cinzotechnologies/RelaxPump/hardware/pcb-v2-netlist.csv

Ref | Pin | Pin name | Net
U1 | L1 | 3V3 | +3V3
U1 | L2 | EN | EN
U1 | L3 | SENSOR_VP / G36 | NC
U1 | L4 | SENSOR_VN / G39 | ECHO_MAIN
U1 | L5 | G34 | ECHO_T4
U1 | L6 | G35 | ECHO_T5
U1 | L7 | G32 | GATE_V4
U1 | L8 | G33 | GATE_PUMP
U1 | L9 | G25 | GATE_V1
U1 | L10 | G26 | GATE_V2
U1 | L11 | G27 | GATE_V3
U1 | L12 | G14 | TRIG_T5_IO
U1 | L13 | G12 | NC (strapping)
U1 | L14 | GND | GND
U1 | L15 | G13 | TRIG_T4_IO
U1 | L16 | SD2 / G9 | NC (flash)
U1 | L17 | SD3 / G10 | NC (flash)
U1 | L18 | CMD / G11 | NC (flash)
U1 | L19 | 5V | +5V
U1 | R1 | GND | GND
U1 | R2 | G23 | TRIG_T3_IO
U1 | R3 | G22 | GATE_V5
U1 | R4 | TX / G1 | NC (USB serial)
U1 | R5 | RX / G3 | NC (USB serial)
U1 | R6 | G21 | TRIG_MAIN_IO
U1 | R7 | GND | GND
U1 | R8 | G19 | ECHO_T2
U1 | R9 | G18 | TRIG_T2_IO
U1 | R10 | G5 | SPARE_G5
U1 | R11 | G17 | ECHO_T1
U1 | R12 | G16 | TRIG_T1_IO
U1 | R13 | G4 | ECHO_T3
U1 | R14 | G0 | SW_SETUP
U1 | R15 | G2 | LED_STATUS
U1 | R16 | G15 | NC (strapping)
U1 | R17 | SD1 / G8 | NC (flash)
U1 | R18 | SD0 / G7 | NC (flash)
U1 | R19 | CLK / G6 | NC (flash)
J1 | 1 | + | VIN_RAW
J1 | 2 | − | GND
F1 | 1 | IN | VIN_RAW
F1 | 2 | OUT | VIN_FUSED
D1 | A | Anode | VIN_FUSED
D1 | K | Cathode | +12V
D2 | K | Cathode | +12V
D2 | A | Anode | GND
C1 | + | + | +12V
C1 | − | − | GND
C2 | 1 | 1 | +12V
C2 | 2 | 2 | GND
U2 | 1 | IN+ | +12V
U2 | 2 | IN− | GND
U2 | 3 | OUT+ | +5V
U2 | 4 | OUT− | GND
C3 | + | + | +5V
C3 | − | − | GND
C4 | 1 | 1 | +5V
C4 | 2 | 2 | GND
LED8 | A | Anode | PWR_LED_A
LED8 | K | Cathode | GND
R38 | 1 | 1 | +5V
R38 | 2 | 2 | PWR_LED_A
J2 | 1 | +12V | +12V
J2 | 2 | SW− | V1_OUT
Q1 | G | Gate | GATE_V1_G
Q1 | S | Source | GND
Q1 | D | Drain | V1_OUT
R7 | 1 | 1 | GATE_V1
R7 | 2 | 2 | GATE_V1_G
R13 | 1 | 1 | GATE_V1_G
R13 | 2 | 2 | GND
D3 | K | Cathode | +12V
D3 | A | Anode | V1_OUT
R1 | 1 | 1 | +12V
R1 | 2 | 2 | V1_LED_A
LED1 | A | Anode | V1_LED_A
LED1 | K | Cathode | V1_OUT
J3 | 1 | +12V | +12V
J3 | 2 | SW− | V2_OUT
Q2 | G | Gate | GATE_V2_G
Q2 | S | Source | GND
Q2 | D | Drain | V2_OUT
R8 | 1 | 1 | GATE_V2
R8 | 2 | 2 | GATE_V2_G
R14 | 1 | 1 | GATE_V2_G
R14 | 2 | 2 | GND
D4 | K | Cathode | +12V
D4 | A | Anode | V2_OUT
R2 | 1 | 1 | +12V
R2 | 2 | 2 | V2_LED_A
LED2 | A | Anode | V2_LED_A
LED2 | K | Cathode | V2_OUT
J4 | 1 | +12V | +12V
J4 | 2 | SW− | V3_OUT
Q3 | G | Gate | GATE_V3_G
Q3 | S | Source | GND
Q3 | D | Drain | V3_OUT
R9 | 1 | 1 | GATE_V3
R9 | 2 | 2 | GATE_V3_G
R15 | 1 | 1 | GATE_V3_G
R15 | 2 | 2 | GND
D5 | K | Cathode | +12V
D5 | A | Anode | V3_OUT
R3 | 1 | 1 | +12V
R3 | 2 | 2 | V3_LED_A
LED3 | A | Anode | V3_LED_A
LED3 | K | Cathode | V3_OUT
J5 | 1 | +12V | +12V
J5 | 2 | SW− | V4_OUT
Q4 | G | Gate | GATE_V4_G
Q4 | S | Source | GND
Q4 | D | Drain | V4_OUT
R10 | 1 | 1 | GATE_V4
R10 | 2 | 2 | GATE_V4_G
R16 | 1 | 1 | GATE_V4_G
R16 | 2 | 2 | GND
D6 | K | Cathode | +12V
D6 | A | Anode | V4_OUT
R4 | 1 | 1 | +12V
R4 | 2 | 2 | V4_LED_A
LED4 | A | Anode | V4_LED_A
LED4 | K | Cathode | V4_OUT
J6 | 1 | +12V | +12V
J6 | 2 | SW− | V5_OUT
Q5 | G | Gate | GATE_V5_G
Q5 | S | Source | GND
Q5 | D | Drain | V5_OUT
R11 | 1 | 1 | GATE_V5
R11 | 2 | 2 | GATE_V5_G
R17 | 1 | 1 | GATE_V5_G
R17 | 2 | 2 | GND
D7 | K | Cathode | +12V
D7 | A | Anode | V5_OUT
R5 | 1 | 1 | +12V
R5 | 2 | 2 | V5_LED_A
LED5 | A | Anode | V5_LED_A
LED5 | K | Cathode | V5_OUT
J7 | 1 | +12V | +12V
J7 | 2 | SW− | PUMP_OUT
Q6 | G | Gate | GATE_PUMP_G
Q6 | S | Source | GND
Q6 | D | Drain | PUMP_OUT
R12 | 1 | 1 | GATE_PUMP
R12 | 2 | 2 | GATE_PUMP_G
R18 | 1 | 1 | GATE_PUMP_G
R18 | 2 | 2 | GND
D8 | K | Cathode | +12V
D8 | A | Anode | PUMP_OUT
R6 | 1 | 1 | +12V
R6 | 2 | 2 | PUMP_LED_A
LED6 | A | Anode | PUMP_LED_A
LED6 | K | Cathode | PUMP_OUT
J8 | 1 | orange-white | NC
J8 | 2 | orange | NC
J8 | 3 | green-white | GND
J8 | 4 | blue | TRIG_T1
J8 | 5 | blue-white | GND
J8 | 6 | green | ECHO_T1_5V
J8 | 7 | brown-white | GND
J8 | 8 | brown | +5V
R31 | 1 | 1 | TRIG_T1_IO
R31 | 2 | 2 | TRIG_T1
R19 | 1 | 1 | ECHO_T1_5V
R19 | 2 | 2 | ECHO_T1
R25 | 1 | 1 | ECHO_T1
R25 | 2 | 2 | GND
D9 | 1 | IO1 | TRIG_T1
D9 | 2 | IO2 | ECHO_T1_5V
D9 | 3 | GND | GND
J9 | 1 | orange-white | NC
J9 | 2 | orange | NC
J9 | 3 | green-white | GND
J9 | 4 | blue | TRIG_T2
J9 | 5 | blue-white | GND
J9 | 6 | green | ECHO_T2_5V
J9 | 7 | brown-white | GND
J9 | 8 | brown | +5V
R32 | 1 | 1 | TRIG_T2_IO
R32 | 2 | 2 | TRIG_T2
R20 | 1 | 1 | ECHO_T2_5V
R20 | 2 | 2 | ECHO_T2
R26 | 1 | 1 | ECHO_T2
R26 | 2 | 2 | GND
D10 | 1 | IO1 | TRIG_T2
D10 | 2 | IO2 | ECHO_T2_5V
D10 | 3 | GND | GND
J10 | 1 | orange-white | NC
J10 | 2 | orange | NC
J10 | 3 | green-white | GND
J10 | 4 | blue | TRIG_T3
J10 | 5 | blue-white | GND
J10 | 6 | green | ECHO_T3_5V
J10 | 7 | brown-white | GND
J10 | 8 | brown | +5V
R33 | 1 | 1 | TRIG_T3_IO
R33 | 2 | 2 | TRIG_T3
R21 | 1 | 1 | ECHO_T3_5V
R21 | 2 | 2 | ECHO_T3
R27 | 1 | 1 | ECHO_T3
R27 | 2 | 2 | GND
D11 | 1 | IO1 | TRIG_T3
D11 | 2 | IO2 | ECHO_T3_5V
D11 | 3 | GND | GND
J11 | 1 | orange-white | NC
J11 | 2 | orange | NC
J11 | 3 | green-white | GND
J11 | 4 | blue | TRIG_T4
J11 | 5 | blue-white | GND
J11 | 6 | green | ECHO_T4_5V
J11 | 7 | brown-white | GND
J11 | 8 | brown | +5V
R34 | 1 | 1 | TRIG_T4_IO
R34 | 2 | 2 | TRIG_T4
R22 | 1 | 1 | ECHO_T4_5V
R22 | 2 | 2 | ECHO_T4
R28 | 1 | 1 | ECHO_T4
R28 | 2 | 2 | GND
D12 | 1 | IO1 | TRIG_T4
D12 | 2 | IO2 | ECHO_T4_5V
D12 | 3 | GND | GND
J12 | 1 | orange-white | NC
J12 | 2 | orange | NC
J12 | 3 | green-white | GND
J12 | 4 | blue | TRIG_T5
J12 | 5 | blue-white | GND
J12 | 6 | green | ECHO_T5_5V
J12 | 7 | brown-white | GND
J12 | 8 | brown | +5V
R35 | 1 | 1 | TRIG_T5_IO
R35 | 2 | 2 | TRIG_T5
R23 | 1 | 1 | ECHO_T5_5V
R23 | 2 | 2 | ECHO_T5
R29 | 1 | 1 | ECHO_T5
R29 | 2 | 2 | GND
D13 | 1 | IO1 | TRIG_T5
D13 | 2 | IO2 | ECHO_T5_5V
D13 | 3 | GND | GND
J13 | 1 | orange-white | NC
J13 | 2 | orange | NC
J13 | 3 | green-white | GND
J13 | 4 | blue | TRIG_MAIN
J13 | 5 | blue-white | GND
J13 | 6 | green | ECHO_MAIN_5V
J13 | 7 | brown-white | GND
J13 | 8 | brown | +5V
R36 | 1 | 1 | TRIG_MAIN_IO
R36 | 2 | 2 | TRIG_MAIN
R24 | 1 | 1 | ECHO_MAIN_5V
R24 | 2 | 2 | ECHO_MAIN
R30 | 1 | 1 | ECHO_MAIN
R30 | 2 | 2 | GND
D14 | 1 | IO1 | TRIG_MAIN
D14 | 2 | IO2 | ECHO_MAIN_5V
D14 | 3 | GND | GND
LED7 | A | Anode | LED_STATUS_A
LED7 | K | Cathode | GND
R37 | 1 | 1 | LED_STATUS
R37 | 2 | 2 | LED_STATUS_A
SW1 | 1 | 1 | SW_SETUP
SW1 | 2 | 2 | GND
SW2 | 1 | 1 | EN
SW2 | 2 | 2 | GND
J14 | 1 | 3V3 | +3V3
J14 | 2 | G5 | SPARE_G5
J14 | 3 | GND | GND
