cinzotechnologies/RelaxPump/HOW-TO-V2-MIZO.md

# RelaxPump v2 (tank 1–5) – Claude Code-a siam dan

Plan kim chu `docs/flexible-system.md` ah a awm a, app screen design thar chu `reference/design-v2/` ah a awm.

- Semi tank 1–5, tank tinah sensor + valve (tank 1 chauh chuan sensor chauh).
- Relay 6: valve 5 + pump 1. Main tank sensor duh thlan theih. PHE a awm lo.

1. Terminal hawng la:

   ```
   cd D:\RelaxPump-kit
   claude
   ```

2. Folder access a dil chuan **Allow** ti rawh.
3. `FLEX_START_PROMPT.txt` chhunga thu zawng zawng copy la, Claude Code-ah paste rawh.
4. Milestone plan a lantir hunah en la, "OK, tan rawh" ti rawh.
5. Milestone tin zawhah app hi design-v2 nen khaikhin rawh. A danglam chuan file hming sawiin hrilh rawh.
6. Board flash, wiring emaw Firebase emaw a ngaih hunah step a rawn hrilh ang che.

**Hriat tur:** website (`web/`) leh hei hi Claude Code session hrang hrangah ti rawh.
