cinzotechnologies/RelaxPump/HOW-TO-MIZO.md

# RelaxPump – Claude Code-a tan dan

1. He folder (RelaxPump-kit) hi i computer-ah dah la, a hming "RelaxPump" ah thlak rawh.
2. Terminal hawng la, chu folder-ah lut rawh:  cd RelaxPump
3. Claude Code tan rawh:  claude
4. START_PROMPT.txt chhunga thu zawng zawng kha copy la, Claude Code-ah paste rawh.
5. A plan a rawn lantir hunah en la, "OK, tan rawh" ti rawh.
6. Firebase console, phone emaw ESP32 lamah i thiltih tur a awm chuan a rawn hrilh ang che.

CLAUDE.md hi Claude Code-in a chhiar nghal ang. Chu chuan project dan zawng zawng a sawi a ni.
google-services.json leh secrets.h hi repo-ah push suh (repo hi public a ni).
