cinzotechnologies/RelaxPump/hardware/kicad/RelaxPump_v2.kicad_sch

## KiCad design hardware/kicad/RelaxPump_v2.kicad_sch (2026-11-10)

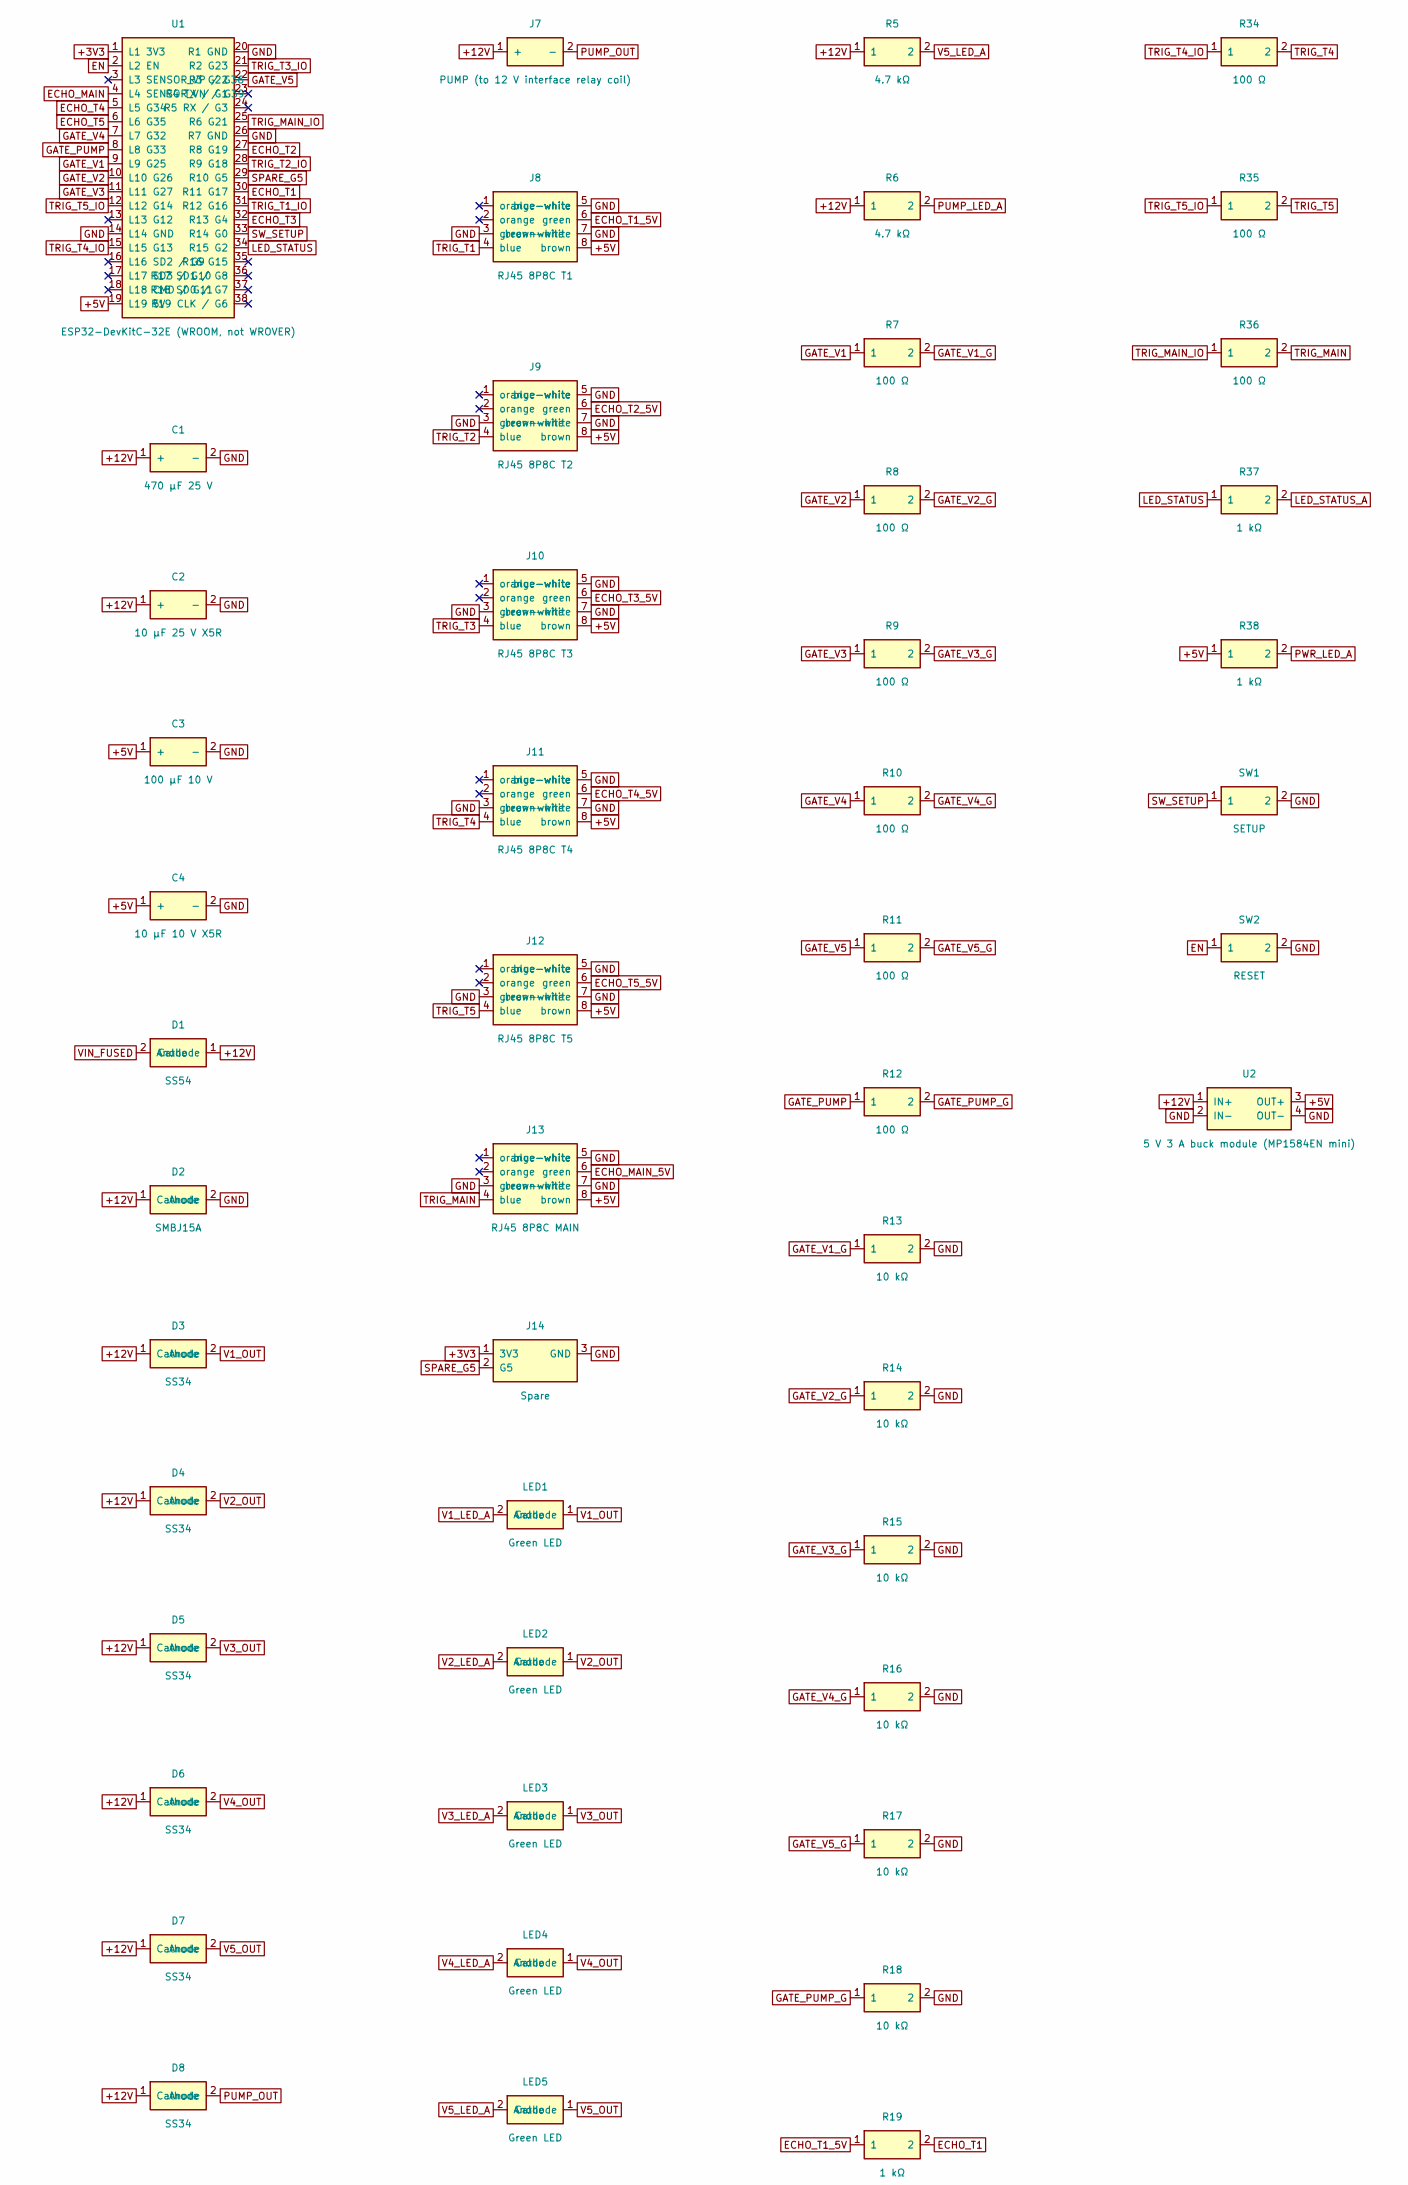
[picture p14: schematic RelaxPump_v2.kicad_sch, part in row 1, column 1]

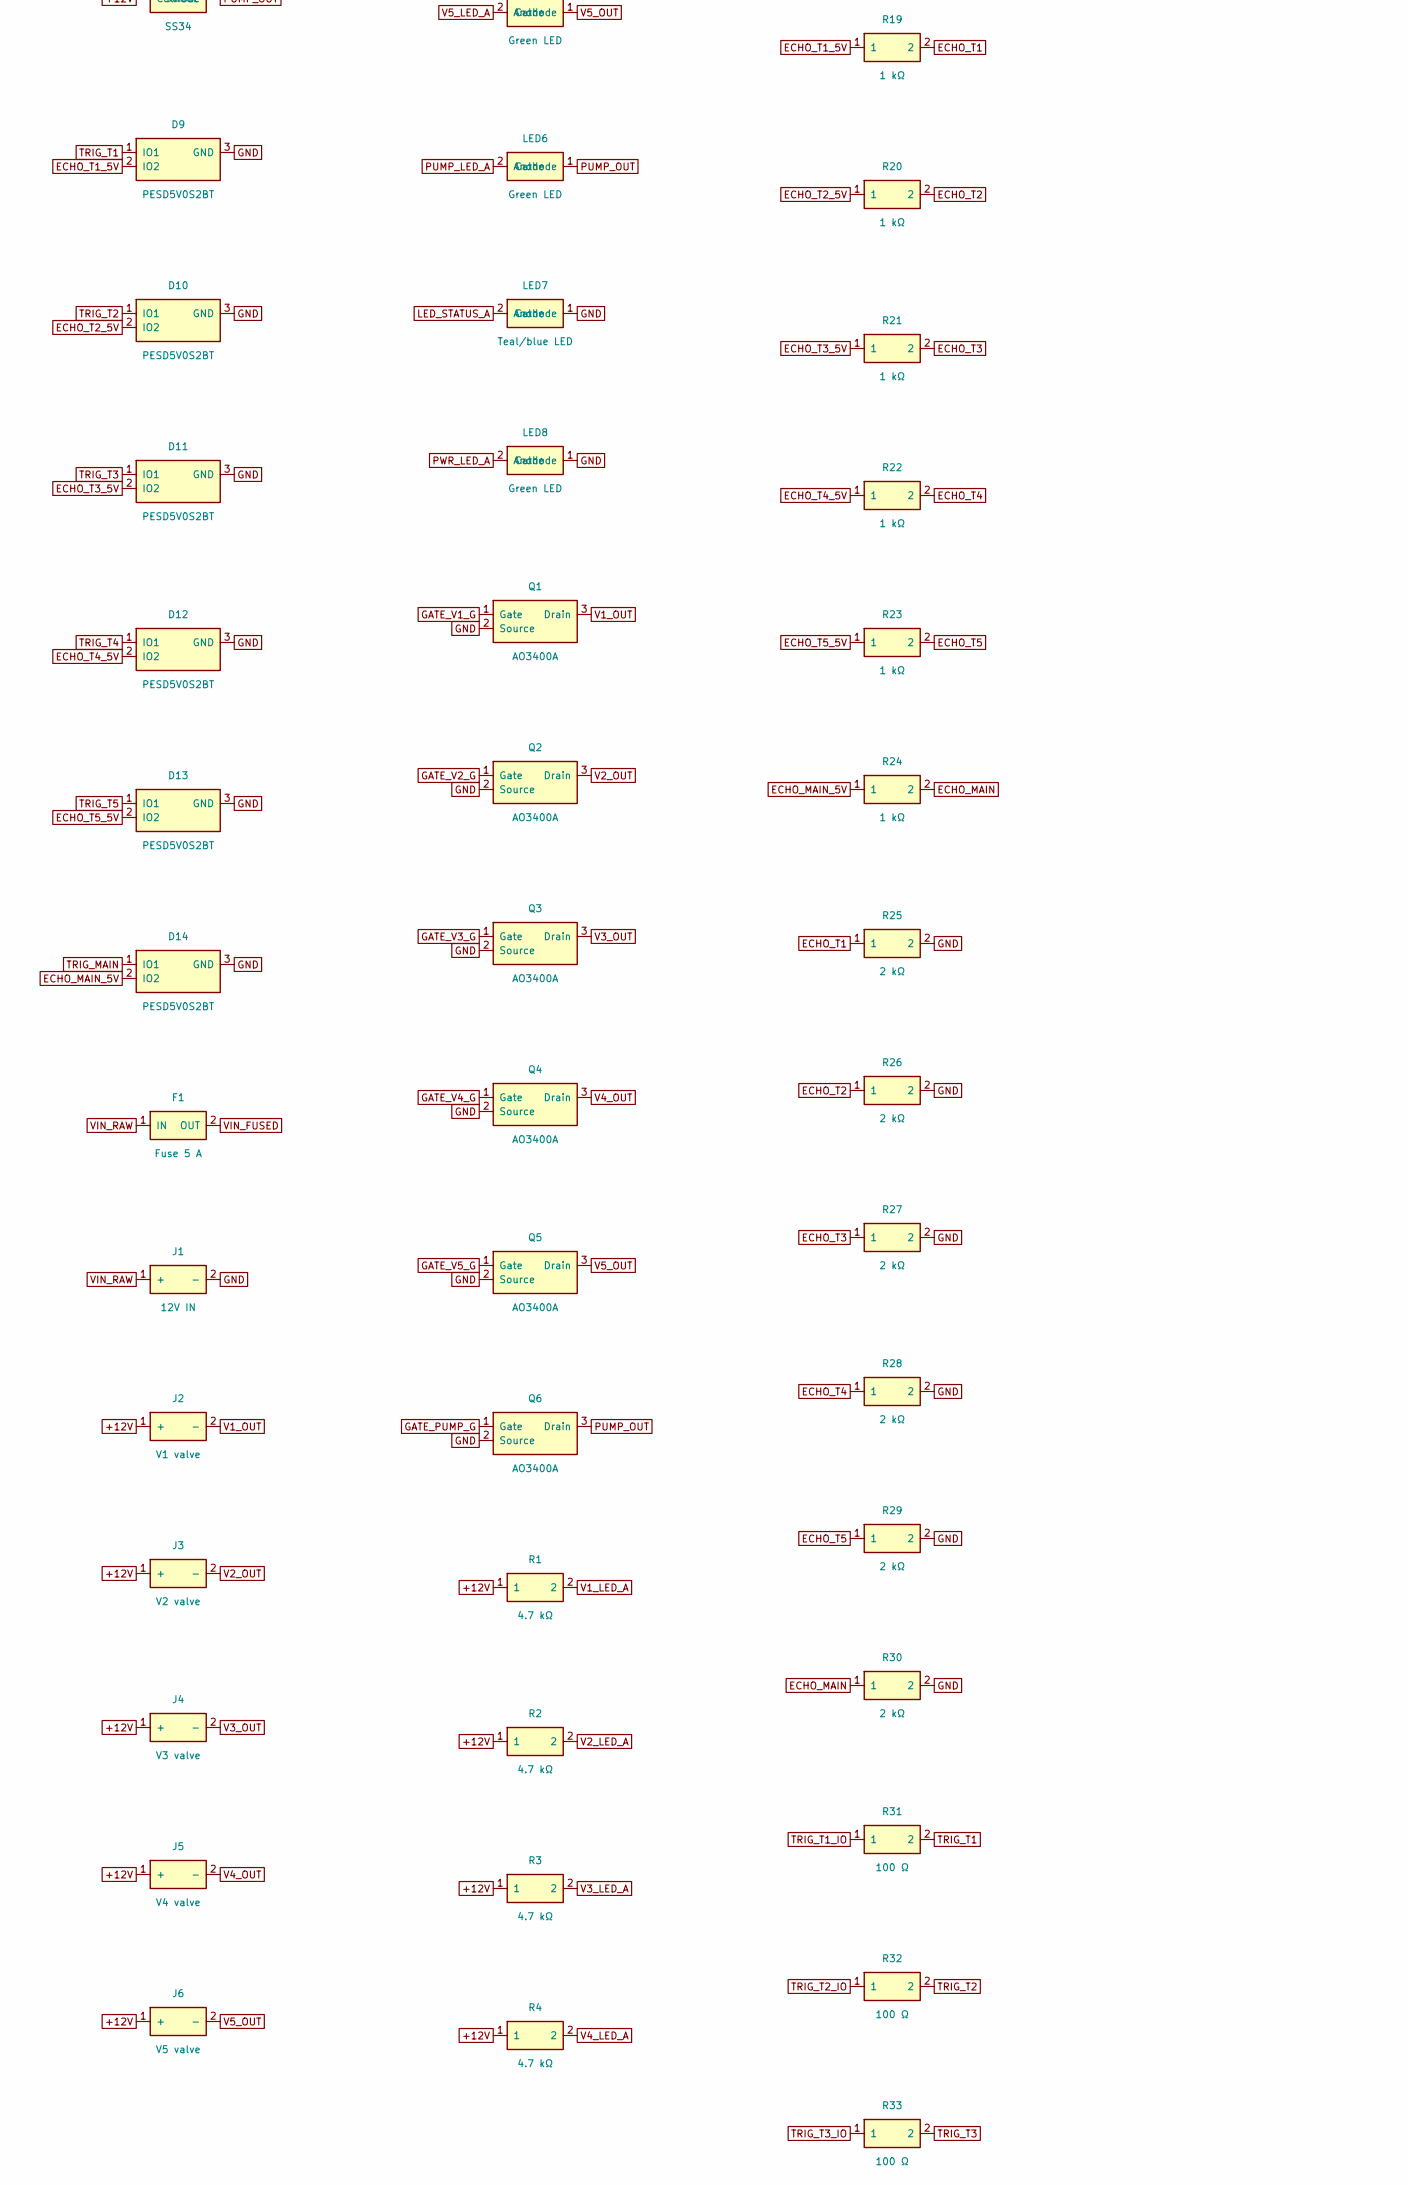
[picture p15: schematic RelaxPump_v2.kicad_sch, part in row 2, column 1]

Parts:
C1: 470 µF 25 V; CP_Radial_D10.0mm_P5.00mm
C2: 10 µF 25 V X5R; C_1206_3216Metric
C3: 100 µF 10 V; CP_Radial_D6.3mm_P2.50mm
C4: 10 µF 10 V X5R; C_0805_2012Metric
D1: SS54; D_SMA
D2: SMBJ15A; D_SMB
D3, D4, D5, D6, D7, D8: SS34; D_SMA
D9, D10, D11, D12, D13, D14: PESD5V0S2BT; SOT-23
F1: Fuse 5 A; Fuseholder_Blade_Mini_Keystone_3568
J1: 12V IN; TerminalBlock_Phoenix_MKDS-1,5-2-5.08_1x02_P5.08mm_Horizont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
J2: V1 valve; TerminalBlock_Phoenix_MKDS-1,5-2-5.08_1x02_P5.08mm_Horizont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
J3: V2 valve; TerminalBlock_Phoenix_MKDS-1,5-2-5.08_1x02_P5.08mm_Horizont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
J4: V3 valve; TerminalBlock_Phoenix_MKDS-1,5-2-5.08_1x02_P5.08mm_Horizont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
J5: V4 valve; TerminalBlock_Phoenix_MKDS-1,5-2-5.08_1x02_P5.08mm_Horizont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
J6: V5 valve; TerminalBlock_Phoenix_MKDS-1,5-2-5.08_1x02_P5.08mm_Horizont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
J7: PUMP (to 12 V interface relay coil); TerminalBlock_Phoenix_MKDS-1,5-2-5.08_1x02_P5.08mm_Horizont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
J8: RJ45 8P8C T1; RJ45_Amphenol_54602-x08_Horizontal
J9: RJ45 8P8C T2; RJ45_Amphenol_54602-x08_Horizontal
J10: RJ45 8P8C T3; RJ45_Amphenol_54602-x08_Horizontal
J11: RJ45 8P8C T4; RJ45_Amphenol_54602-x08_Horizontal
J12: RJ45 8P8C T5; RJ45_Amphenol_54602-x08_Horizontal
J13: RJ45 8P8C MAIN; RJ45_Amphenol_54602-x08_Horizontal
J14: Spare; PinHeader_1x03_P2.54mm_Vertical
LED1, LED2, LED3, LED4, LED5, LED6, LED8: Green LED; LED_0805_2012Metric
LED7: Teal/blue LED; LED_0805_2012Metric
Q1, Q2, Q3, Q4, Q5, Q6: AO3400A; SOT-23
R1, R2, R3, R4, R5, R6: 4.7 kΩ; R_0603_1608Metric
R7, R8, R9, R10, R11, R12, R31, R32, R33, R34, R35, R36: 100 Ω; R_0603_1608Metric
R13, R14, R15, R16, R17, R18: 10 kΩ; R_0603_1608Metric
R19, R20, R21, R22, R23, R24, R37, R38: 1 kΩ; R_0603_1608Metric
R25, R26, R27, R28, R29, R30: 2 kΩ; R_0603_1608Metric
SW1: SETUP; SW_PUSH_6mm
SW2: RESET; SW_PUSH_6mm
U1: ESP32-DevKitC-32E (WROOM, not WROVER); ESP32-DevKitC-38pin_2x19_P2.54mm_Row25.4mm
U2: 5 V 3 A buck module (MP1584EN mini); MP1584_Module_4pin

Connections:
+3V3: J14.1 (3V3), U1.1 (L1 3V3)
+5V: C3.1 (+), C4.1 (+), J8.8 (brown), J9.8 (brown), J10.8 (brown), J11.8 (brown), J12.8 (brown), J13.8 (brown), R38.1, U1.19 (L19 5V), U2.3 (OUT+)
+12V: C1.1 (+), C2.1 (+), D1.1 (Cathode), D2.1 (Cathode), D3.1 (Cathode), D4.1 (Cathode), D5.1 (Cathode), D6.1 (Cathode), D7.1 (Cathode), D8.1 (Cathode), J2.1 (+), J3.1 (+), J4.1 (+), J5.1 (+), J6.1 (+), J7.1 (+), R1.1, R2.1, R3.1, R4.1, R5.1, R6.1, U2.1 (IN+)
ECHO_MAIN: R24.2, R30.1, U1.4 (L4 SENSOR_VN / G39)
ECHO_MAIN_5V: D14.2 (IO2), J13.6 (green), R24.1
ECHO_T1: R19.2, R25.1, U1.30 (R11 G17)
ECHO_T1_5V: D9.2 (IO2), J8.6 (green), R19.1
ECHO_T2: R20.2, R26.1, U1.27 (R8 G19)
ECHO_T2_5V: D10.2 (IO2), J9.6 (green), R20.1
ECHO_T3: R21.2, R27.1, U1.32 (R13 G4)
ECHO_T3_5V: D11.2 (IO2), J10.6 (green), R21.1
ECHO_T4: R22.2, R28.1, U1.5 (L5 G34)
ECHO_T4_5V: D12.2 (IO2), J11.6 (green), R22.1
ECHO_T5: R23.2, R29.1, U1.6 (L6 G35)
ECHO_T5_5V: D13.2 (IO2), J12.6 (green), R23.1
EN: SW2.1, U1.2 (L2 EN)
GATE_PUMP: R12.1, U1.8 (L8 G33)
GATE_PUMP_G: Q6.1 (Gate), R12.2, R18.1
GATE_V1: R7.1, U1.9 (L9 G25)
GATE_V1_G: Q1.1 (Gate), R7.2, R13.1
GATE_V2: R8.1, U1.10 (L10 G26)
GATE_V2_G: Q2.1 (Gate), R8.2, R14.1
GATE_V3: R9.1, U1.11 (L11 G27)
GATE_V3_G: Q3.1 (Gate), R9.2, R15.1
GATE_V4: R10.1, U1.7 (L7 G32)
GATE_V4_G: Q4.1 (Gate), R10.2, R16.1
GATE_V5: R11.1, U1.22 (R3 G22)
GATE_V5_G: Q5.1 (Gate), R11.2, R17.1
GND: C1.2 (−), C2.2 (−), C3.2 (−), C4.2 (−), D2.2 (Anode), D9.3 (GND), D10.3 (GND), D11.3 (GND), D12.3 (GND), D13.3 (GND), D14.3 (GND), J1.2 (−), J8.3 (green-white), J8.5 (blue-white), J8.7 (brown-white), J9.3 (green-white), J9.5 (blue-white), J9.7 (brown-white), J10.3 (green-white), J10.5 (blue-white), J10.7 (brown-white), J11.3 (green-white), J11.5 (blue-white), J11.7 (brown-white), J12.3 (green-white), J12.5 (blue-white), J12.7 (brown-white), J13.3 (green-white), J13.5 (blue-white), J13.7 (brown-white), J14.3 (GND), LED7.1 (Cathode), LED8.1 (Cathode), Q1.2 (Source), Q2.2 (Source), Q3.2 (Source), Q4.2 (Source), Q5.2 (Source), Q6.2 (Source), R13.2, R14.2, R15.2, R16.2, R17.2, R18.2, R25.2, R26.2, R27.2, R28.2, R29.2, R30.2, SW1.2, SW2.2, U1.14 (L14 GND), U1.20 (R1 GND), U1.26 (R7 GND), U2.2 (IN−), U2.4 (OUT−)
LED_STATUS: R37.1, U1.34 (R15 G2)
LED_STATUS_A: LED7.2 (Anode), R37.2
PUMP_LED_A: LED6.2 (Anode), R6.2
PUMP_OUT: D8.2 (Anode), J7.2 (−), LED6.1 (Cathode), Q6.3 (Drain)
PWR_LED_A: LED8.2 (Anode), R38.2
SPARE_G5: J14.2 (G5), U1.29 (R10 G5)
SW_SETUP: SW1.1, U1.33 (R14 G0)
TRIG_MAIN: D14.1 (IO1), J13.4 (blue), R36.2
TRIG_MAIN_IO: R36.1, U1.25 (R6 G21)
TRIG_T1: D9.1 (IO1), J8.4 (blue), R31.2
TRIG_T1_IO: R31.1, U1.31 (R12 G16)
TRIG_T2: D10.1 (IO1), J9.4 (blue), R32.2
TRIG_T2_IO: R32.1, U1.28 (R9 G18)
TRIG_T3: D11.1 (IO1), J10.4 (blue), R33.2
TRIG_T3_IO: R33.1, U1.21 (R2 G23)
TRIG_T4: D12.1 (IO1), J11.4 (blue), R34.2
TRIG_T4_IO: R34.1, U1.15 (L15 G13)
TRIG_T5: D13.1 (IO1), J12.4 (blue), R35.2
TRIG_T5_IO: R35.1, U1.12 (L12 G14)
V1_LED_A: LED1.2 (Anode), R1.2
V1_OUT: D3.2 (Anode), J2.2 (−), LED1.1 (Cathode), Q1.3 (Drain)
V2_LED_A: LED2.2 (Anode), R2.2
V2_OUT: D4.2 (Anode), J3.2 (−), LED2.1 (Cathode), Q2.3 (Drain)
V3_LED_A: LED3.2 (Anode), R3.2
V3_OUT: D5.2 (Anode), J4.2 (−), LED3.1 (Cathode), Q3.3 (Drain)
V4_LED_A: LED4.2 (Anode), R4.2
V4_OUT: D6.2 (Anode), J5.2 (−), LED4.1 (Cathode), Q4.3 (Drain)
V5_LED_A: LED5.2 (Anode), R5.2
V5_OUT: D7.2 (Anode), J6.2 (−), LED5.1 (Cathode), Q5.3 (Drain)
VIN_FUSED: D1.2 (Anode), F1.2 (OUT)
VIN_RAW: F1.1 (IN), J1.1 (+)
