cinzotechnologies/RelaxPump/(commit log)

2026-11-07 M1: repo scaffold (Expo SDK 58 app, PlatformIO, Firebase, docs)
    - app/: Expo Router + TypeScript strict, dev-client, React Native Firebase,
    ESP-IDF BLE provisioning, Reanimated, SVG, bottom sheet, zustand, RHF+zod
    - app.config.ts reads google-services.json from EAS file env when building
    - eas.json with development / preview (APK) / production profiles
    - ESLint (expo) + Prettier + Jest (jest-expo)
    - firmware/ PlatformIO skeleton and tools/ValveTest
    - firebase/ config with locked rules placeholder
    - docs/ hardware plan PDF
2026-11-07 M2+M3: theme, components and all screens on a mock backend
    - Theme tokens, scaled sizes (390 design width), Inter/Outfit type
    - Components: level-ring logo, animated welcome tank, two-layer waves,
    toggle, range slider, segmented control, progress ring, sheets, nav, toast
    - Screens: Welcome, Auth, Home, Tanks, Usage, Account
    - Sheets: Your tanks, Change password, Notifications, Forgot password,
    Bluetooth setup (mock provisioning)
    - Backend interface with an in-memory simulator (Expo Go friendly)
    - Pump safety helpers + unit tests
2026-11-07 M4+M5 (app): Firebase backend, QR + BLE provisioning, device claim
    - Firebase Auth with phone → synthetic email, profile in users/{uid}
    - Live RTDB device info/state/config/events/usage, commands and config writes
    - Claim: SHA-256(deviceId:code) checked by rules, one atomic multi-path write
    - Bluetooth setup: scan box QR (id, PoP, claim code), ESP-IDF BLE
    provisioning (security 1), then claim
    - Expo Go automatically uses the simulator and mock provisioning
    - Local notifications for controller events while the app runs
2026-11-07 M7+M8: database rules with emulator tests, admin scripts, docs
    - database.rules.json: owner-only device access, verified device accounts,
    hash-checked claiming, validated config/cmd/events/usage
    - 18 emulator tests (@firebase/rules-unit-testing), all passing
    - scripts: new-device (device login, claim hash, secrets.h, box QR),
    reset-password (support), fake-device (end-to-end test without ESP32)
    - Cloud Functions stub for Blaze (not deployed)
    - docs: SETUP, data model, Blaze upgrade
2026-11-07 M6: ESP32 firmware with BLE provisioning and Firebase
    - WiFiProv BLE (security 1 + PoP), service RelaxPump-XXXX, BLE memory freed after setup
    - BOOT held 5 s forgets Wi-Fi; status LED patterns; OTA; 15 s task watchdog
    - Safety state machine from the legacy sketch: valve lead 2 s, stop delay 3 s,
    never pump with all valves closed, one tank at a time, max run time,
    dry-run check, 60 s cooldown, stop on sensor error, offline guard
    - Auto fills the lowest tank below Start up to Stop, then the next
    - FirebaseClient: device login, config/cmd streams, state every 3 s and on
    change, events, usage with server-side increments; settings kept in flash
    - Serial bench commands kept; docs/wiring.md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
    [cloud.cpp, cloud.h, config.h, main.cpp]
2026-11-07 Add link-device support script; setup doc for fake device testing
2026-11-08 Store readiness: delete account, offline-safe remote control, quieter nav
    - Account: "Delete account" sheet (Play Store / App Store requirement). Re-auths,
    releases the user's controllers, removes users/{uid}, deletes the auth user.
    - Remote control over Wi-Fi: online state is re-checked every 5 s against server
    time (.info/serverTimeOffset), so a controller that loses power shows Offline.
    Pump / valve / auto commands are refused while offline instead of queueing.
    - Firmware: ignore commands older than 60 s (queued while offline).
    - Bottom nav: icon-only tabs; active tab is a small see-through teal circle with a
    glowing icon instead of a wide solid pill.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
2026-11-08 Notify for everything Auto does; push-ready (FCM tokens)
    - App: local notification now also for pump start/stop done by Auto (not for the
    user's own taps), plus full/low/fault events as before. All events stay in the
    bell list.
    - App saves this phone's FCM token at users/{uid}/fcm/{token} on sign-in, keeps it
    fresh, removes it on sign-out (delete account wipes it with the profile).
    - Rules: users/{uid}/fcm/{token} = true, owner only; emulator test (20/20).
    - Cloud Function onDeviceEvent (still undeployed, needs Blaze): uses tank names,
    pushes auto pump start/stop too, prunes dead tokens.
2026-11-08 W2: colour tokens, shared UI and the site shell (top bar + footer)
    - styles/tokens.ts is the single colour source (brief theme + design shades +
    artwork); the root layout emits them as CSS variables (--ink, --ink-rgb …).
    - styles/site.css: type, white outlined buttons / icon buttons / chips with
    press = scale only, entry + scroll-reveal motion, reduced-motion, and the
    1100 / 820 container breakpoints from the design.
    - Logo, LogoMark, Wordmark, stroke icons; sticky white TopBar with the phone
    burger dropdown; dark Footer with contact info (seed values for now).
    - Playwright screenshot run at 1440 and 390.
2026-11-08 W3: home page — all sections from Main.dc.html at 1440 and 390
    - Hero (16:9, slow zoom photo, white fades, glass outlined buttons, chips).
    - How it works: 4 slides, 6 s auto-advance with progress tabs, clip-path panel
    wipe, phone slide/rotate, outlined big number.
    - App screens: looped coverflow of the 6 AppScreen mockups, chips + arrows.
    - Install guide: 16:9 player, chapters, "Video coming soon" until a video or
    YouTube link exists.
    - Manual: hardcover book with leaves turning around the spine; phone = single
    pages peeling left.
    - Download card with SOON badges, store teaser with Notify me, dark footer.
    - AppScreen component (welcome/home/tanks/usage/ble/account) in the app's dark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
2026-11-08 W4: store page with cart drawer and checkout (ordering closed)
    - /store from Shop.dc.html: crumb, title, "orders open soon" note, category
    chips, product grid with add-to-cart steppers, "Not sure what you need?"
    card, why tiles, store top bar (Store current, cart button with count) and
    the shorter store footer.
    - Cart in localStorage (sanitised on load, max 99 per line), slide-in drawer,
    empty state, summary, checkout form (name, phone, address, town, PIN, COD /
    UPI). "Place order" stays disabled while ordering is closed.
    - Products moved to lib/content/products.ts (seed for D1): 5 items, category,
    nullable price (₹ when set), featured flag for the home teaser.
    - Fixes: closed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
2026-11-09 W7: website editor (draft → publish), media library (R2), preview
    - /admin/website: 8 sections per Admin.dc.html; text, textarea, link, toggle,
    image / video (upload or YouTube) / PDF fields; edits autosave as drafts,
    Publish copies drafts live in one D1 batch (+ store products and ordering
    switch), Discard drops them; "Unpublished changes" + per-section dots
    - Preview: admin-only draft mode shows unpublished changes on / and /store
    - /admin/media: upload (JPG/PNG/WebP/AVIF/GIF, MP4/WebM, PDF; no SVG) with
    progress, where each file is used, delete unused files
    - Server checks every field (https links only, uploads must be our own
    /media files, length limits); deep shape check of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
2026-11-09 W8: forgot-password requests (API, admin, Firebase update, WhatsApp)
    - POST /api/reset-requests (public, for the app): name + 10-digit phone,
    max 3 per phone and 10 per IP a day, one waiting row per phone; the
    answer never says whether the phone has an account
    - /admin/requests: Waiting / Done tabs, list, 3 steps per the design —
    set password (type or Generate: 8 chars, no look-alikes) → Open WhatsApp
    (wa.me with the design's message) → Mark as done (who + when)
    - Firebase: Identity Toolkit REST (accounts:lookup → accounts:update with
    validSince to sign out old sessions) with a service-account token signed
    in the Worker by jose — works on Spark; password never stored or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
2026-11-09 Release prep: push + cleanup on Cloudflare cron, app help/privacy, checklist
    - web/jobs (relaxpump-jobs Worker): every minute pushes new controller
    events to the owner's phones via FCM HTTP v1 (same texts as before, own
    taps skipped, dead tokens removed, per-device cursors in D1, request
    budget for the free plan); daily drops events > 30 days, usage > 1 year,
    handled password requests > 6 months. Replaces Cloud Functions, so the
    app needs no Blaze plan.
    - identity.accessToken takes a scope.
    - App: Account › Help & support (WhatsApp +91 98632 62589) and Privacy
    policy rows; real support number.
    - docs/release.md: secrets to set by hand, build, Play Console (privacy
    URL, data s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
2026-11-09 web: scripts/put-secrets.mjs — upload the three Firebase secrets in one go
2026-11-09 App: voice/shortcut pump control, stay signed in in demo mode
    - relaxpump://do/{pump-on,pump-off,auto-on,auto-off} run without a tap once
    signed in and the controller is online (2-minute expiry). Voice "pump on"
    opens the emptiest tank's valve first when none is open, then starts the
    pump after the controller applied it.
    - Android: app shortcuts + Google Assistant App Actions (custom intents
    with query patterns) via plugins/withVoiceShortcuts.js.
    - Siri: Shortcuts "Open URL" recipe documented (iOS app later).
    - Demo (Expo Go): the signed-in user is remembered across restarts, like
    Firebase in the real app.
    - Notification icon set for Android 8+.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
2026-11-09 App build: skip Kotlin metadata version check (Firebase BoM 35)
    The first preview build failed in :react-native-firebase_auth:compileReleaseKotlin:
    firebase-auth 25 (BoM 35.0.2) has Kotlin 2.4 metadata, the project compiles with
    Kotlin 2.2. plugins/withKotlinMetadataCheck.js adds -Xskip-metadata-version-check
    to every Kotlin compile instead of raising Kotlin (which would move KSP for
    expo-image, expo-updates and async-storage).
2026-11-10 F1: v2 data model, rules with installer PIN, emulator tests, layout helpers
    - firebase/scripts/build-rules.mjs generates database.rules.json: semi[] 1..maxTanks with
    optional sensor/valve (fillMin without sensor, valve on every tank when 2+), main tank, PHE,
    mode, new cmd (fill/phe/test/pumpCheck) and event types, device-written info/ports
    - installer PIN in installerPins/{id} (never readable) + pinAttempts/pinChecks; layout writes
    need the PIN, customer fields (names, litres, low/high, mode) do not; reset-pin script
    - one-time device migration of v1 config; 23 new rules tests (41 total)
    - app/src/model/layout.ts: v2 types, validation, mode/source helpers, v1->v2 reader + tests
    - docs/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
2026-11-10 F2+F3: firmware v2 — fill engine, board v1/v2 pin maps, PHE, main tank, test, pump check
    - lib/engine: pure C++ fill engine (1-8 semi tanks, optional sensor/valve per tank, timed fills,
    Auto lowest-first with height tie-break, modes auto/phe/pump, PHE probe + retry + fallback to
    the pump, main-tank guard with hysteresis, cmd.test pulses, pump check (L/min, slow flag),
    MCP23017 fault lockout). Every CLAUDE.md §7 safety rule kept: 2 s valve lead, 3 s stop,
    one tank at a time, never pump against closed valves, pump and PHE never together, max run,
    dry-run, 60 s cooldown, sensor fail, offline guard
    - 29 host tests (every layout 1-8 tanks, every mode) with plant model + invariant che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
    [board.cpp, board.h, cloud.cpp, cloud.h, config.h, main.cpp, settings.cpp]
2026-11-10 F4: app v2 — installer setup with PIN, dynamic Home/Tanks/Usage, source selector, Pump check, My setup
    - model: v2 types (semi/main/phe/mode, state src/active/detected/check, ports), readers that also
    accept v1 config/state while controllers update
    - backend: patchConfig (customer leaf writes, no PIN), pinStatus/verifyPin/saveSetup/endSetup;
    Firebase and a v2 mock simulator (EXPO_PUBLIC_MOCK_LAYOUT, e.g. "8", "5,phe,main,ns3")
    - Installer setup screen (design-v2 AppSetup): set/enter PIN keypad, 5 steps with validation,
    wiring check (detected sensors, Test buttons), water source, save + wait for the controller;
    opens after a new controller is claimed and from Account / Tanks
    - Home: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
2026-11-10 F5: app tests — setup wizard, v2 state reading, mock layouts, Home/Tanks render for 1 and 8 tanks
    - mock layouts 1/3/5/8 tanks, with/without PHE and main sensor, one no-sensor tank (mockLayout)
    - setup reducer: counts per board, valve rule blocks Next, fill time / main stop limits,
    PHE off drops PHE-only mode, saved config, wiring checks
    - state readers (v1 + v2), tank views and averages for every mock layout
    - Home and Tanks render tests (1 and 8 tanks) with a small Reanimated stand-in (jest/reanimated.js)
    - 66 tests pass
2026-11-10 F6: docs for the v2 flexible system — wiring v1+v2, PCB v2, setup guide, factory scripts
    - docs/wiring.md: v1 and v2 pin maps, active levels, valve-board fault, PHE check valves,
    no-sensor overflow pipe, serial bench commands
    - hardware/pcb-v2.md (+ reference/pcb-v2 concept files): block diagram and firmware notes
    - docs/SETUP.md: new-device --board v1|v2, native tests, migration, installer setup steps,
    PIN reset, rules deploy before v2, family login
    - new-device writes a v2 config + board/ports + RP_BOARD; fake-device reads v2 config
    - README updated
2026-11-10 R1: v2 data model for 1–5 tanks — rules, emulator tests, factory + fake-device scripts
    config = tankCount 1–5 + tanks[] (length = tankCount, ≤ info.maxTanks) + optional main
    (minPct 5–40). Valves implied (2+ tanks → valve each, 1 tank → none). PHE, modes, fill,
    semi[] and info.ports removed; cmd.test V1–V5|PUMP, valve i 0–4. Installer PIN stays in
    installerPins/{id} (not readable). 39 emulator tests pass.
    [pcb-v2-bom.csv, pcb-v2-netlist.csv]
2026-11-10 R2: firmware for 1–5 tanks — one pin map, one-tank mode, main sensor, 2-valve limit
    - engine: MAX_TANKS 5 + MAIN; valves implied (2+ tanks) — one tank pumps direct;
    never more than 2 valves on (only while switching); main < minPct blocks/stops
    the pump; cmd.test V1–V5|PUMP (pump test always opens V1 first); pumpCheck for
    every tank. PHE, modes, timer fills, MCP23017 board fault removed. All §7 rules kept.
    - board: one pin map T1–T5/MAIN/V1–V5/PUMP (docs/flexible-system.md §2); board 1 =
    relays active LOW, board 2 = PCB active HIGH.
    - cloud: state.tanks/main/detected.tanks, info.maxTanks 5, no config migration.
    - 28 host tests (1, 2, 3, 5 tanks, with/without main); esp32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
2026-11-10 R3+R4: app for 1–5 tanks — installer setup, Home/Tanks, main tank, Pump check, My setup, mock layouts + tests
    - model: config = tanks[] (tankCount) + main + low/high/maxRunMin; valves implied
    (2+ tanks); state.tanks/main/detected.tanks; info.maxTanks. PHE, modes, timer
    fills and ports removed. list() keeps RTDB indexes when there are gaps (tank 3
    no longer slides into tank 2's slot).
    - setup (design-v2 AppSetup): count 1–5 with T1–T5/MAIN/PUMP legend and one-tank /
    1→2 valve help, name + size + height per tank, main tank + stop-below, check
    wiring (T1–Tn, MAIN, V1–Vn, PUMP), Save summary with relays used x of 6.
    - Home: main tank card with PUMP SOURCE; Tanks: n of 5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
    [RelaxPump_v2.kicad_sch]
2026-11-10 R5: docs for 1–5 tanks — wiring (6 relays, T1–T5 + MAIN), setup guide, README, PIN note
